mugesram/LoraAgriNode/results/powertest_lora_2026-10-07.csv

pc_time | node | round | rssi_dbm | snr_db | radio_wake_us | ping_setup_us | ping_air_us | pong_setup_us | pong_wait_us | data_setup_us | data_air_us | ack_setup_us | ack_wait_us
2026-10-07 16:12:08 | 2593 | 0 | -17.0 | 12.8 | 25990 | 460 | 36680 | 370 | 79480 | 540 | 67420 | 370 | 80210
2026-10-07 16:12:10 | 2593 | 1 | -20.0 | 13.0 | 1850 | 460 | 36540 | 370 | 79610 | 540 | 67320 | 370 | 80310
2026-10-07 16:12:12 | 2593 | 2 | -18.0 | 12.5 | 1190 | 450 | 36530 | 370 | 80090 | 530 | 67330 | 370 | 80290
2026-10-07 16:12:14 | 2593 | 3 | -20.0 | 12.2 | 1730 | 460 | 36550 | 360 | 79710 | 540 | 67330 | 370 | 80310
2026-10-07 16:12:16 | 2593 | 4 | -21.0 | 12.2 | 2060 | 460 | 36550 | 370 | 79270 | 530 | 67340 | 370 | 80360
2026-10-07 16:12:18 | 2593 | 5 | -24.0 | 12.2 | 1450 | 450 | 36550 | 360 | 79900 | 530 | 67320 | 370 | 80270
2026-10-07 16:12:20 | 2593 | 6 | -23.0 | 13.2 | 1930 | 450 | 36560 | 370 | 79510 | 540 | 67330 | 370 | 80340
2026-10-07 16:12:22 | 2593 | 7 | -23.0 | 12.5 | 1240 | 460 | 36550 | 370 | 79810 | 530 | 67340 | 360 | 80320
2026-10-07 16:12:24 | 2593 | 8 | -23.0 | 12.8 | 1960 | 460 | 36560 | 370 | 79980 | 530 | 67340 | 370 | 80320
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
