mugesram/LoraAgriNode/results/scope_cycle_2026-10-07/full_reduced.csv

time_ms | volts | amps | amps_zero_removed
0.000 | 0.025497 | 0.127487 | 0.000204
0.100 | 0.025510 | 0.127550 | 0.000267
0.200 | 0.025517 | 0.127583 | 0.000300
0.300 | 0.025505 | 0.127525 | 0.000242
0.400 | 0.025507 | 0.127533 | 0.000250
0.500 | 0.025502 | 0.127508 | 0.000225
0.600 | 0.025498 | 0.127492 | 0.000208
0.700 | 0.025503 | 0.127517 | 0.000233
0.800 | 0.025494 | 0.127471 | 0.000188
0.900 | 0.025492 | 0.127462 | 0.000179
1.000 | 0.025497 | 0.127487 | 0.000204
1.100 | 0.025494 | 0.127471 | 0.000188
1.200 | 0.025500 | 0.127500 | 0.000217
1.300 | 0.025510 | 0.127550 | 0.000267
1.400 | 0.025503 | 0.127517 | 0.000233
1.500 | 0.025502 | 0.127508 | 0.000225
1.600 | 0.025506 | 0.127529 | 0.000246
1.700 | 0.025509 | 0.127546 | 0.000263
1.800 | 0.025498 | 0.127492 | 0.000208
1.900 | 0.025487 | 0.127437 | 0.000154
2.000 | 0.025480 | 0.127400 | 0.000117
2.100 | 0.025473 | 0.127367 | 0.000083
2.200 | 0.025485 | 0.127425 | 0.000142
2.300 | 0.025495 | 0.127475 | 0.000192
2.400 | 0.025496 | 0.127479 | 0.000196
2.500 | 0.025497 | 0.127487 | 0.000204
2.600 | 0.025488 | 0.127442 | 0.000158
2.700 | 0.025503 | 0.127517 | 0.000233
2.800 | 0.025523 | 0.127617 | 0.000333
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
