mugesram/LoraAgriNode/results/scope_lora_2026-10-07/C1_2_reduced.csv

time_ms | volts | amps
0.000 | 0.000667 | 0.000133
0.100 | 0.000667 | 0.000133
0.200 | 0.000658 | 0.000132
0.300 | 0.000667 | 0.000133
0.400 | 0.000667 | 0.000133
0.500 | 0.000665 | 0.000133
0.600 | 0.000660 | 0.000132
0.700 | 0.000658 | 0.000132
0.800 | 0.000668 | 0.000134
0.900 | 0.000670 | 0.000134
1.000 | 0.000665 | 0.000133
1.100 | 0.000668 | 0.000134
1.200 | 0.000667 | 0.000133
1.300 | 0.000667 | 0.000133
1.400 | 0.000670 | 0.000134
1.500 | 0.000660 | 0.000132
1.600 | 0.000643 | 0.000129
1.700 | 0.000657 | 0.000131
1.800 | 0.000663 | 0.000133
1.900 | 0.000668 | 0.000134
2.000 | 0.000685 | 0.000137
2.100 | 0.000688 | 0.000138
2.200 | 0.000673 | 0.000135
2.300 | 0.000695 | 0.000139
2.400 | 0.000683 | 0.000137
2.500 | 0.000677 | 0.000135
2.600 | 0.000683 | 0.000137
2.700 | 0.000682 | 0.000136
2.800 | 0.000667 | 0.000133
2.900 | 0.000667 | 0.000133
3.000 | 0.000657 | 0.000131
3.100 | 0.000668 | 0.000134
3.200 | 0.000655 | 0.000131
3.300 | 0.000662 | 0.000132
3.400 | 0.000673 | 0.000135
3.500 | 0.000690 | 0.000138
3.600 | 0.000712 | 0.000142
3.700 | 0.000733 | 0.000147
3.800 | 0.000717 | 0.000143
3.900 | 0.000670 | 0.000134
4.000 | 0.000668 | 0.000134
4.100 | 0.000667 | 0.000133
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
