mugesram/LoraAgriNode/results/scope_lora_2026-10-07/C1_3_reduced.csv

time_ms | volts | amps
0.000 | 0.025498 | 0.127492
0.100 | 0.025493 | 0.127467
0.200 | 0.025498 | 0.127492
0.300 | 0.025500 | 0.127500
0.400 | 0.025502 | 0.127508
0.500 | 0.025495 | 0.127475
0.600 | 0.025483 | 0.127417
0.700 | 0.025492 | 0.127458
0.800 | 0.025475 | 0.127375
0.900 | 0.025478 | 0.127392
1.000 | 0.025477 | 0.127383
1.100 | 0.025492 | 0.127458
1.200 | 0.025490 | 0.127450
1.300 | 0.025482 | 0.127408
1.400 | 0.025462 | 0.127308
1.500 | 0.025420 | 0.127100
1.600 | 0.025415 | 0.127075
1.700 | 0.025428 | 0.127142
1.800 | 0.025432 | 0.127158
1.900 | 0.025373 | 0.126867
2.000 | 0.025377 | 0.126883
2.100 | 0.025403 | 0.127017
2.200 | 0.025418 | 0.127092
2.300 | 0.025410 | 0.127050
2.400 | 0.025415 | 0.127075
2.500 | 0.025395 | 0.126975
2.600 | 0.025377 | 0.126883
2.700 | 0.025403 | 0.127017
2.800 | 0.025432 | 0.127158
2.900 | 0.025455 | 0.127275
3.000 | 0.025448 | 0.127242
3.100 | 0.025445 | 0.127225
3.200 | 0.025438 | 0.127192
3.300 | 0.025425 | 0.127125
3.400 | 0.025460 | 0.127300
3.500 | 0.025418 | 0.127092
3.600 | 0.025472 | 0.127358
3.700 | 0.025490 | 0.127450
3.800 | 0.025495 | 0.127475
3.900 | 0.025463 | 0.127317
4.000 | 0.025442 | 0.127208
4.100 | 0.025438 | 0.127192
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
