mugesram/LoraAgriNode/results/scope_lora_2026-10-07/lora_reduced.csv

time_ms | volts | amps | amps_zero_removed
0.000 | 0.025897 | 0.129483 | 0.000883
0.100 | 0.025890 | 0.129450 | 0.000850
0.200 | 0.025890 | 0.129450 | 0.000850
0.300 | 0.025840 | 0.129200 | 0.000600
0.400 | 0.025770 | 0.128850 | 0.000250
0.500 | 0.025707 | 0.128533 | -0.000067
0.600 | 0.025743 | 0.128717 | 0.000117
0.700 | 0.025797 | 0.128983 | 0.000383
0.800 | 0.025750 | 0.128750 | 0.000150
0.900 | 0.025813 | 0.129067 | 0.000467
1.000 | 0.025713 | 0.128567 | -0.000033
1.100 | 0.025607 | 0.128033 | -0.000567
1.200 | 0.025540 | 0.127700 | -0.000900
1.300 | 0.025633 | 0.128167 | -0.000433
1.400 | 0.025690 | 0.128450 | -0.000150
1.500 | 0.025737 | 0.128683 | 0.000083
1.600 | 0.025720 | 0.128600 | 0.000000
1.700 | 0.025617 | 0.128083 | -0.000517
1.800 | 0.025570 | 0.127850 | -0.000750
1.900 | 0.025623 | 0.128117 | -0.000483
2.000 | 0.025710 | 0.128550 | -0.000050
2.100 | 0.025770 | 0.128850 | 0.000250
2.200 | 0.025787 | 0.128933 | 0.000333
2.300 | 0.025723 | 0.128617 | 0.000017
2.400 | 0.025663 | 0.128317 | -0.000283
2.500 | 0.025603 | 0.128017 | -0.000583
2.600 | 0.025583 | 0.127917 | -0.000683
2.700 | 0.025643 | 0.128217 | -0.000383
2.800 | 0.025713 | 0.128567 | -0.000033
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
