mugesram/LoraAgriNode/results/scope_cycle_2026-10-07/full.png

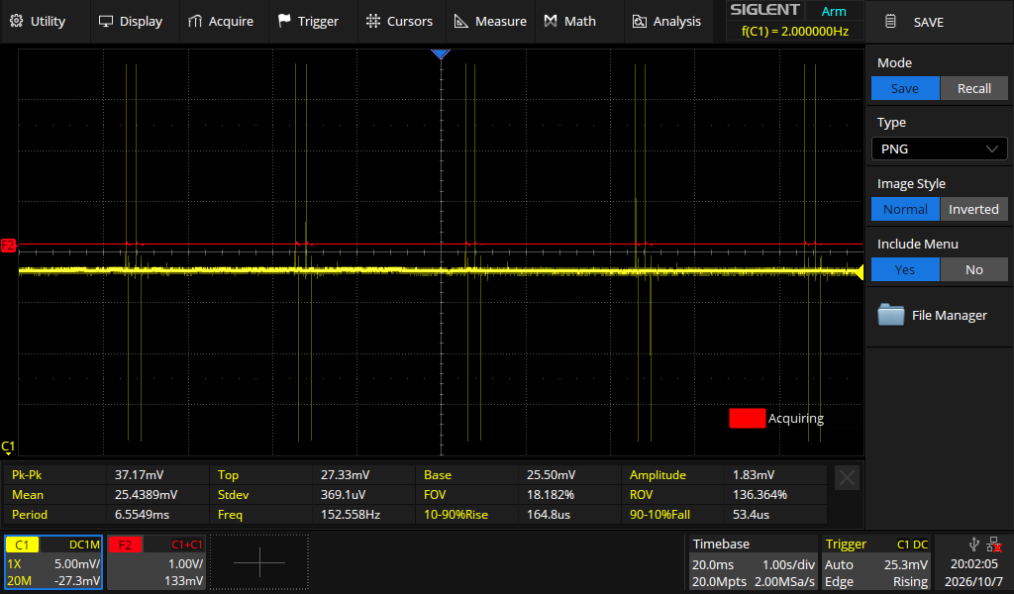
results/scope_cycle_2026-10-07/full.png
