mugesram/LoraAgriNode/results/scope_lora_2026-10-07/lora.png

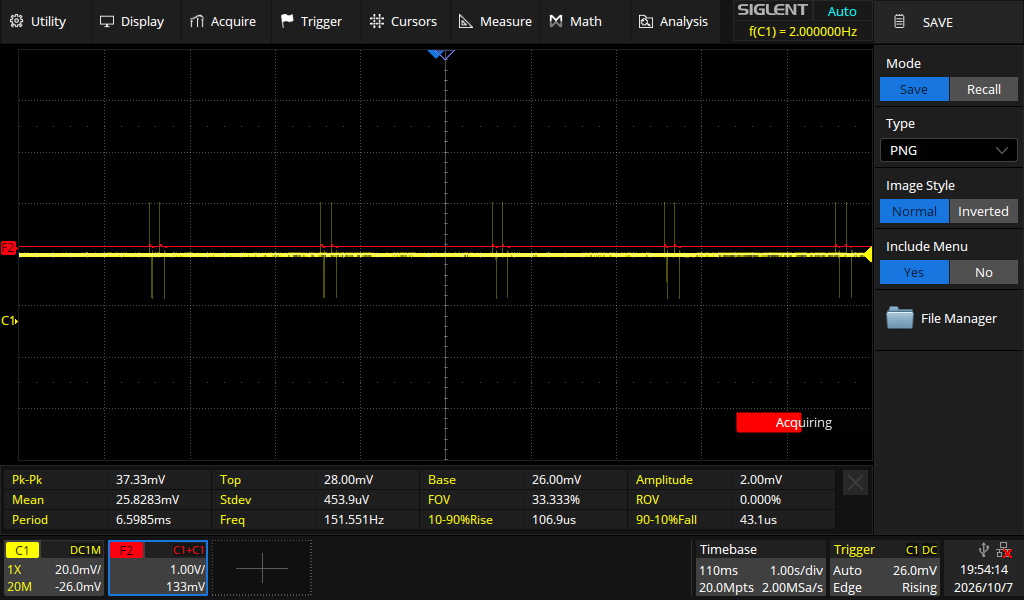
results/scope_lora_2026-10-07/lora.png
