mugesram/LoraAgriNode/results/scope_lora_2026-10-07/scope_1.png

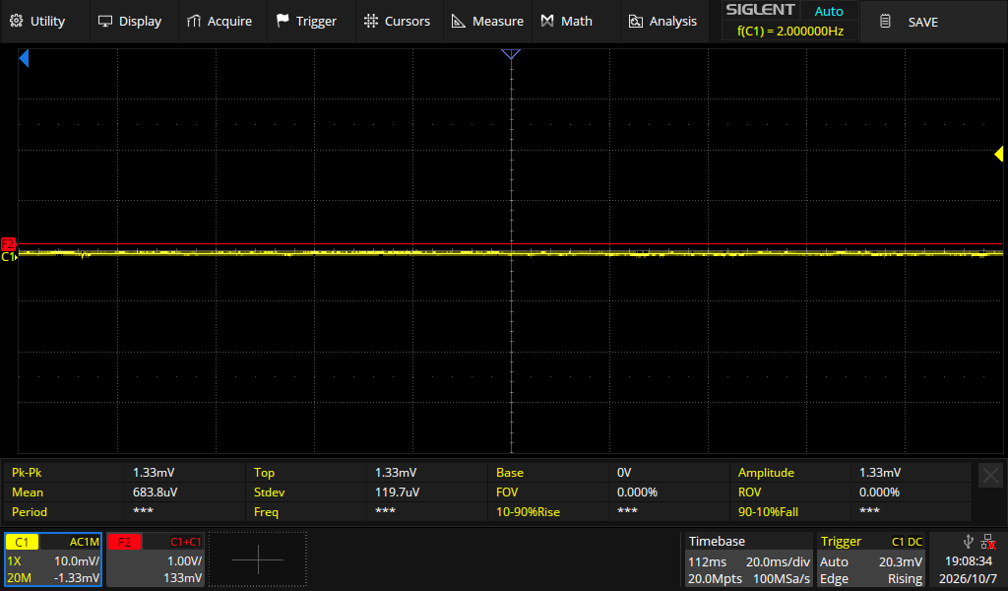
results/scope_lora_2026-10-07/scope_1.png
