mugesram/LoraAgriNode/results/scope_lora_2026-10-07/scope_2.png

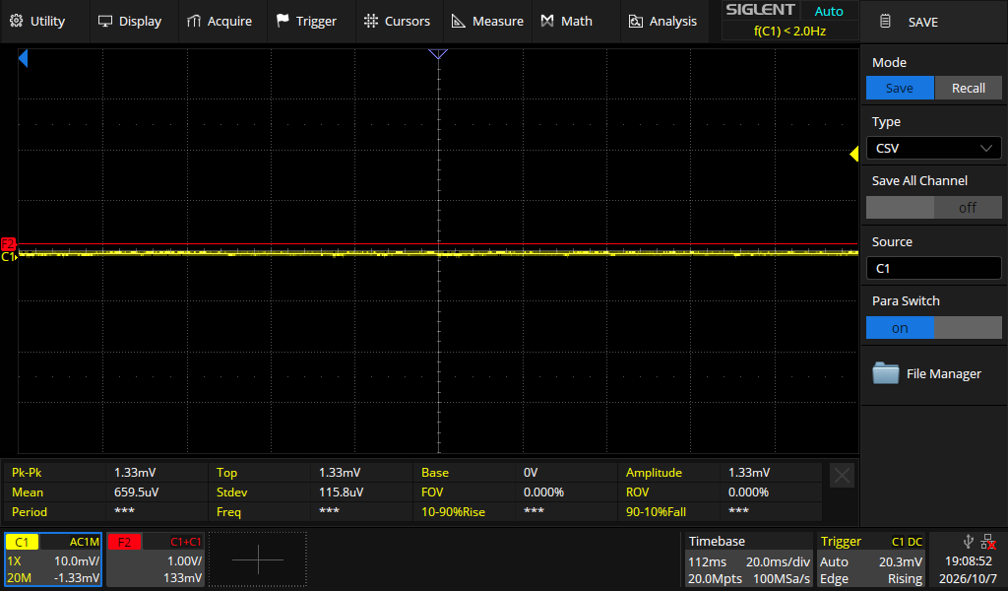
results/scope_lora_2026-10-07/scope_2.png
