mugesram/LoraAgriNode/results/scope_shunt_1R1_2026-10-07/fullres.png

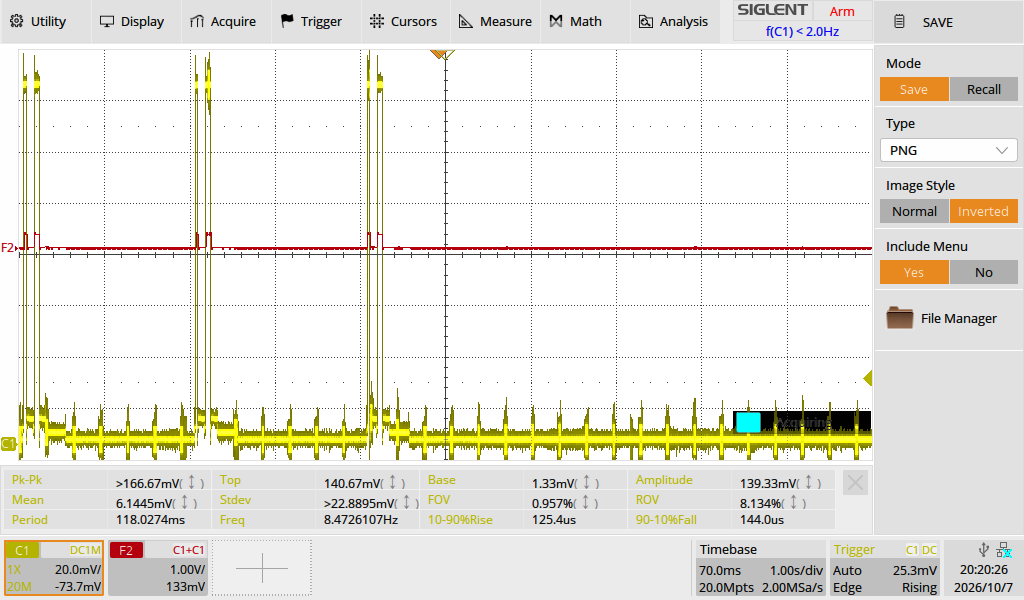
results/scope_shunt_1R1_2026-10-07/fullres.png
