mugesram/LoraAgriNode/hardware/entc-sensornode-1_schematic.pdf

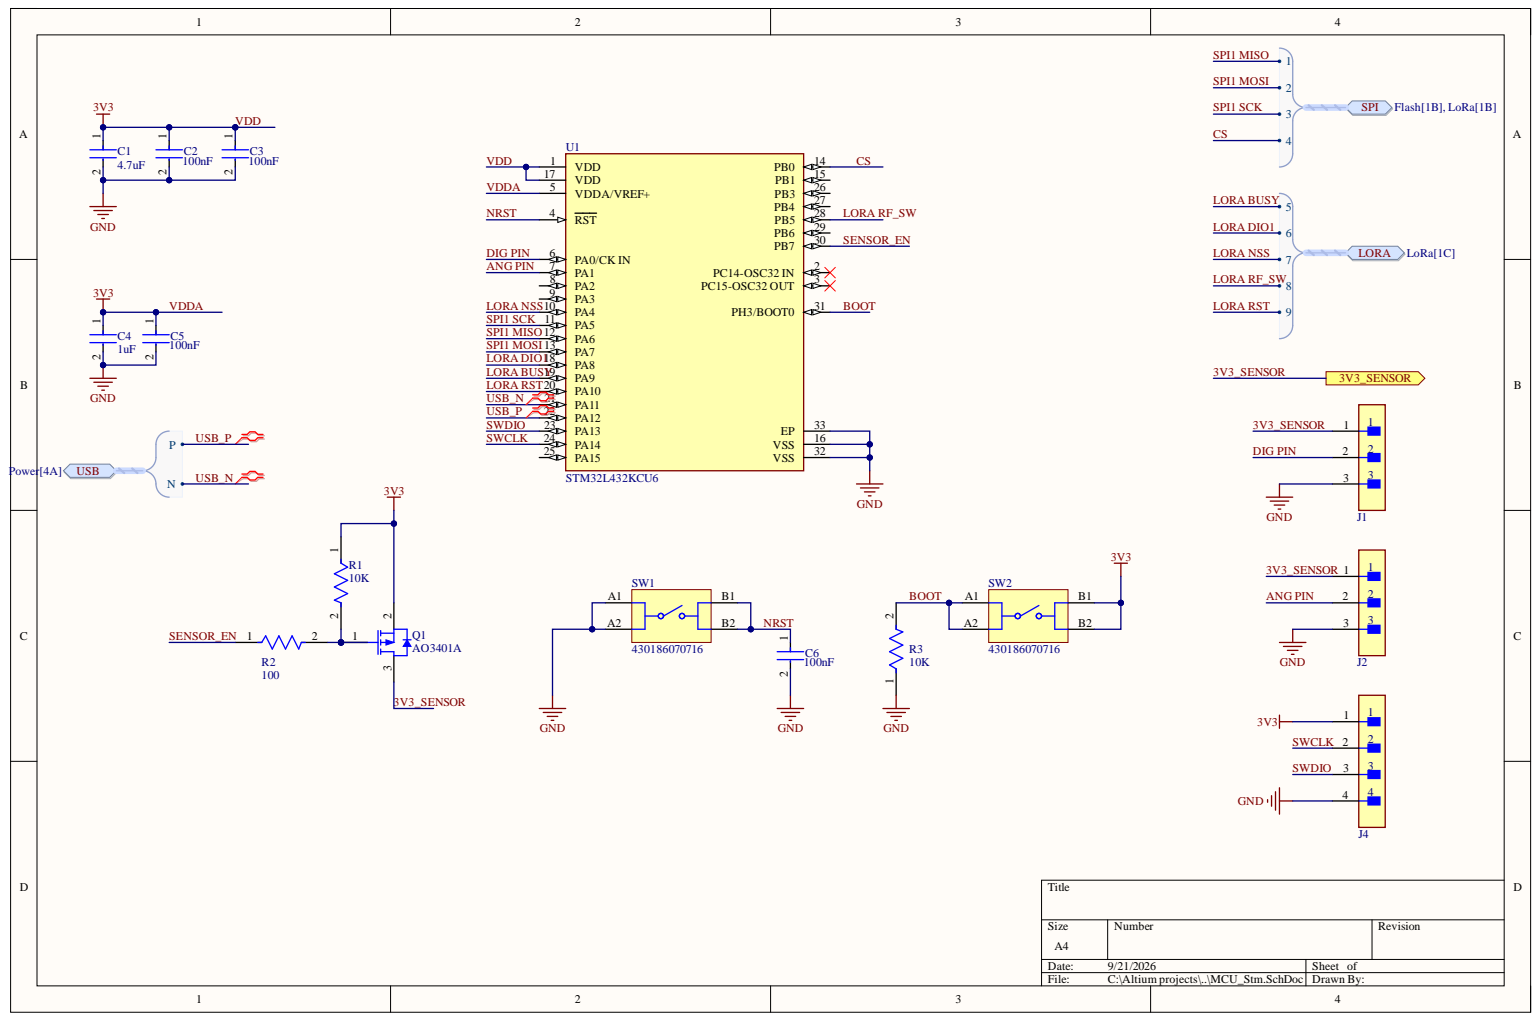
[picture p10: page 1]

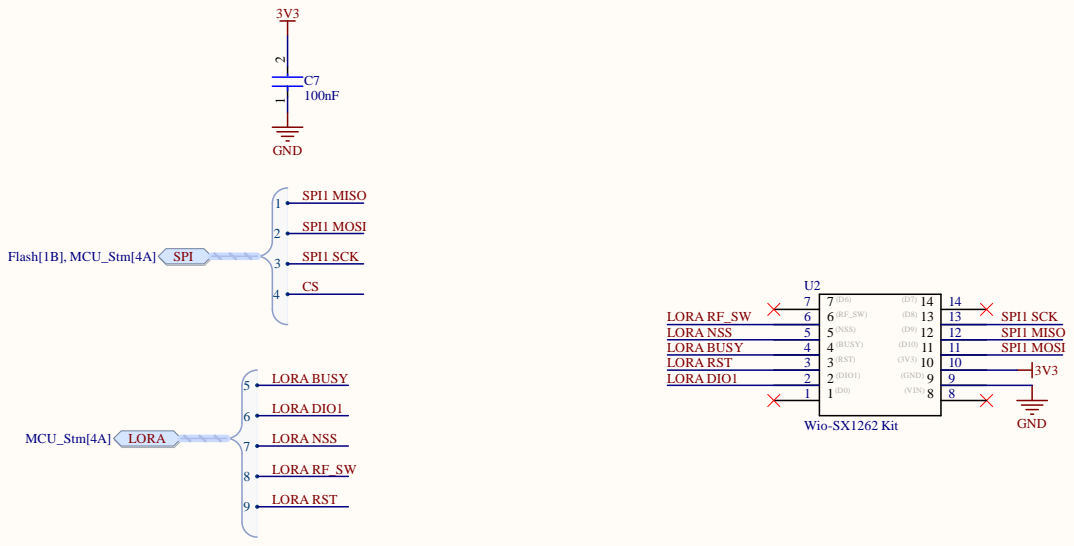
[picture p11: page 2]
Title; Size; Number; Revision; Date:; Sheet of; File:; C:\Altium projects\..\LoRa.SchDoc; Drawn By:; SPI1 MISO; SPI1 SCK; LORA RST; LORA NSS; LORA BUSY; SPI1 MOSI; LORA DIO1; LORA RF_SW; 5 ⁽NSS); 4 ⁽BUSY); 3 ⁽RST); 2 ⁽DIO1); 9 ⁽GND); 8 ⁽VIN); Wio-SX1262 Kit; GND; MCU_Stm[4A]; LORA; Flash[1B], MCU_Stm[4A]; SPI

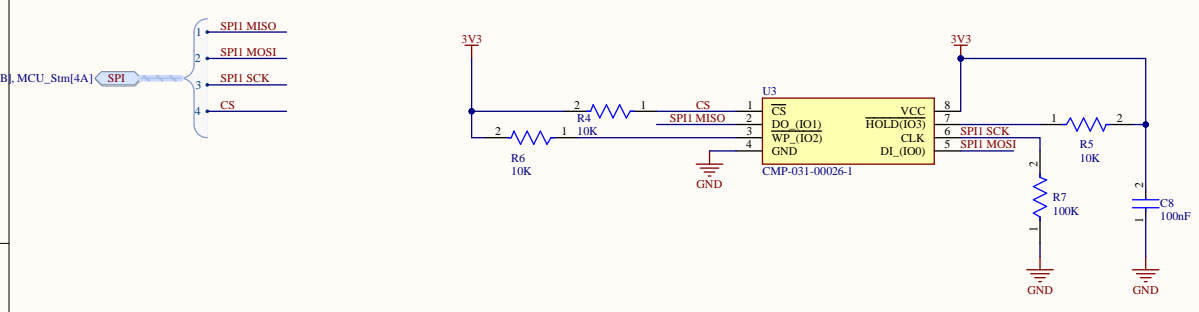
[picture p12: page 3]
Size; umb; Rev; Dat; Sheet; project; \..\Flas; Draw; VCC; CMP-0; SPI1 SCK SPI1 MOSI; CS SPI1 MISO; SPI1 MISO; SPI1 MOSI; SPI1 SCK; oRa[1B], MCU; _Stm[4; SPI

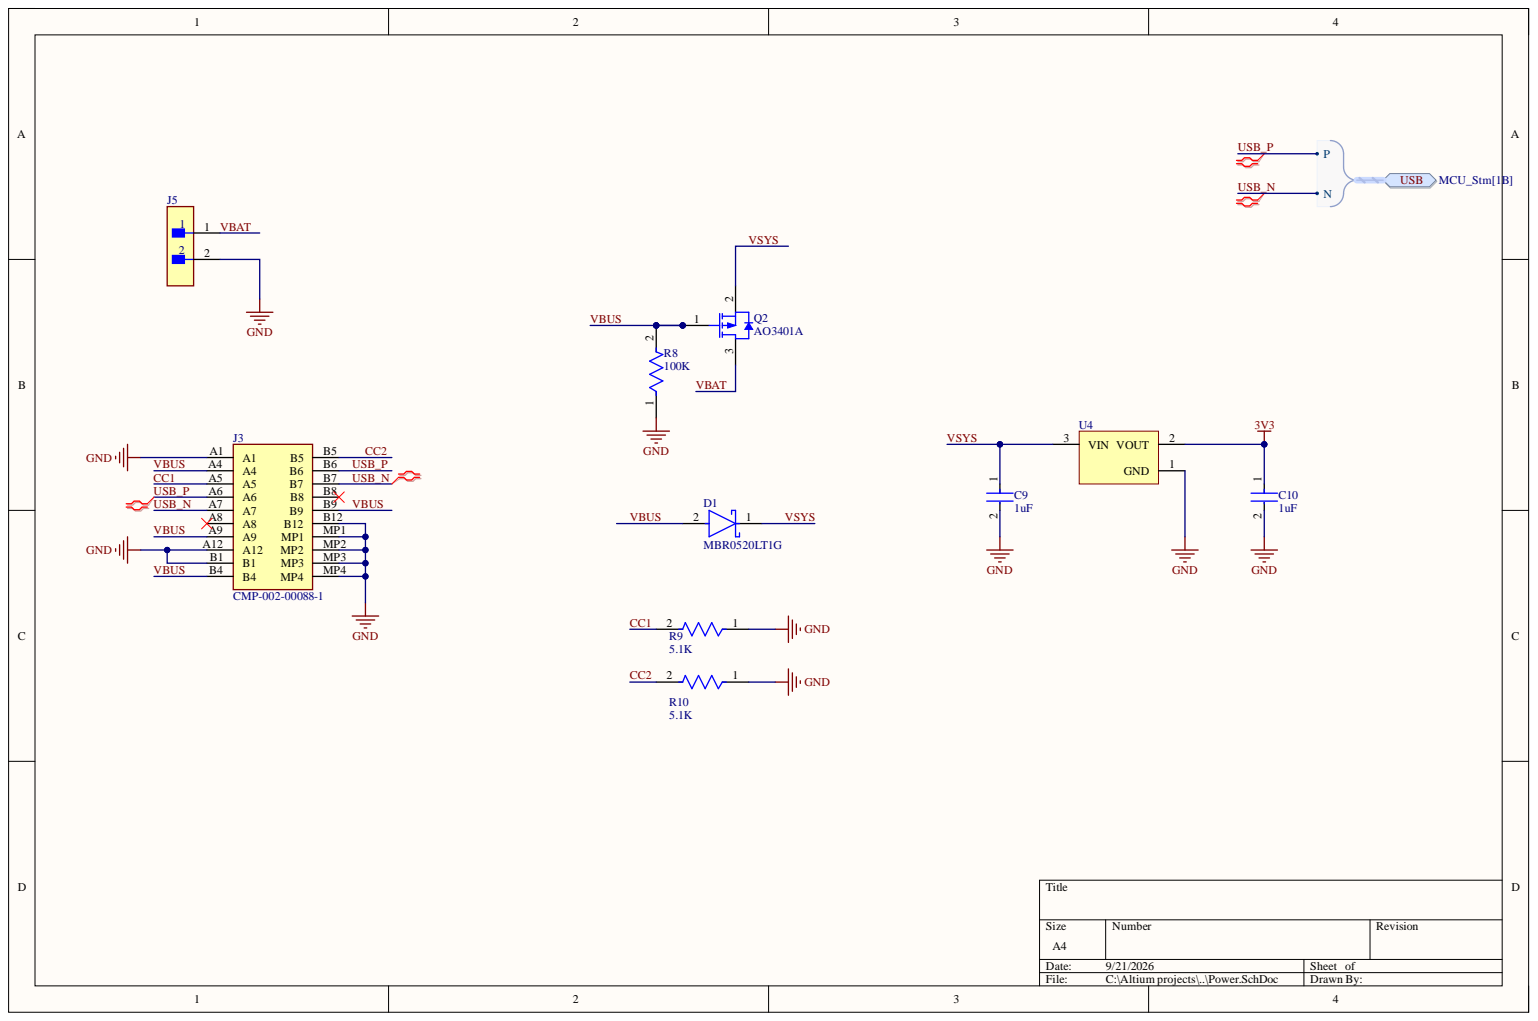
[picture p13: page 4]
Size; umb; Rev; Dat; Sheet; project; wer.Sc; Draw; VBAT; VSY; CMP-0; USB_; MBR0; VBU; USB; MCU; _Stm[1

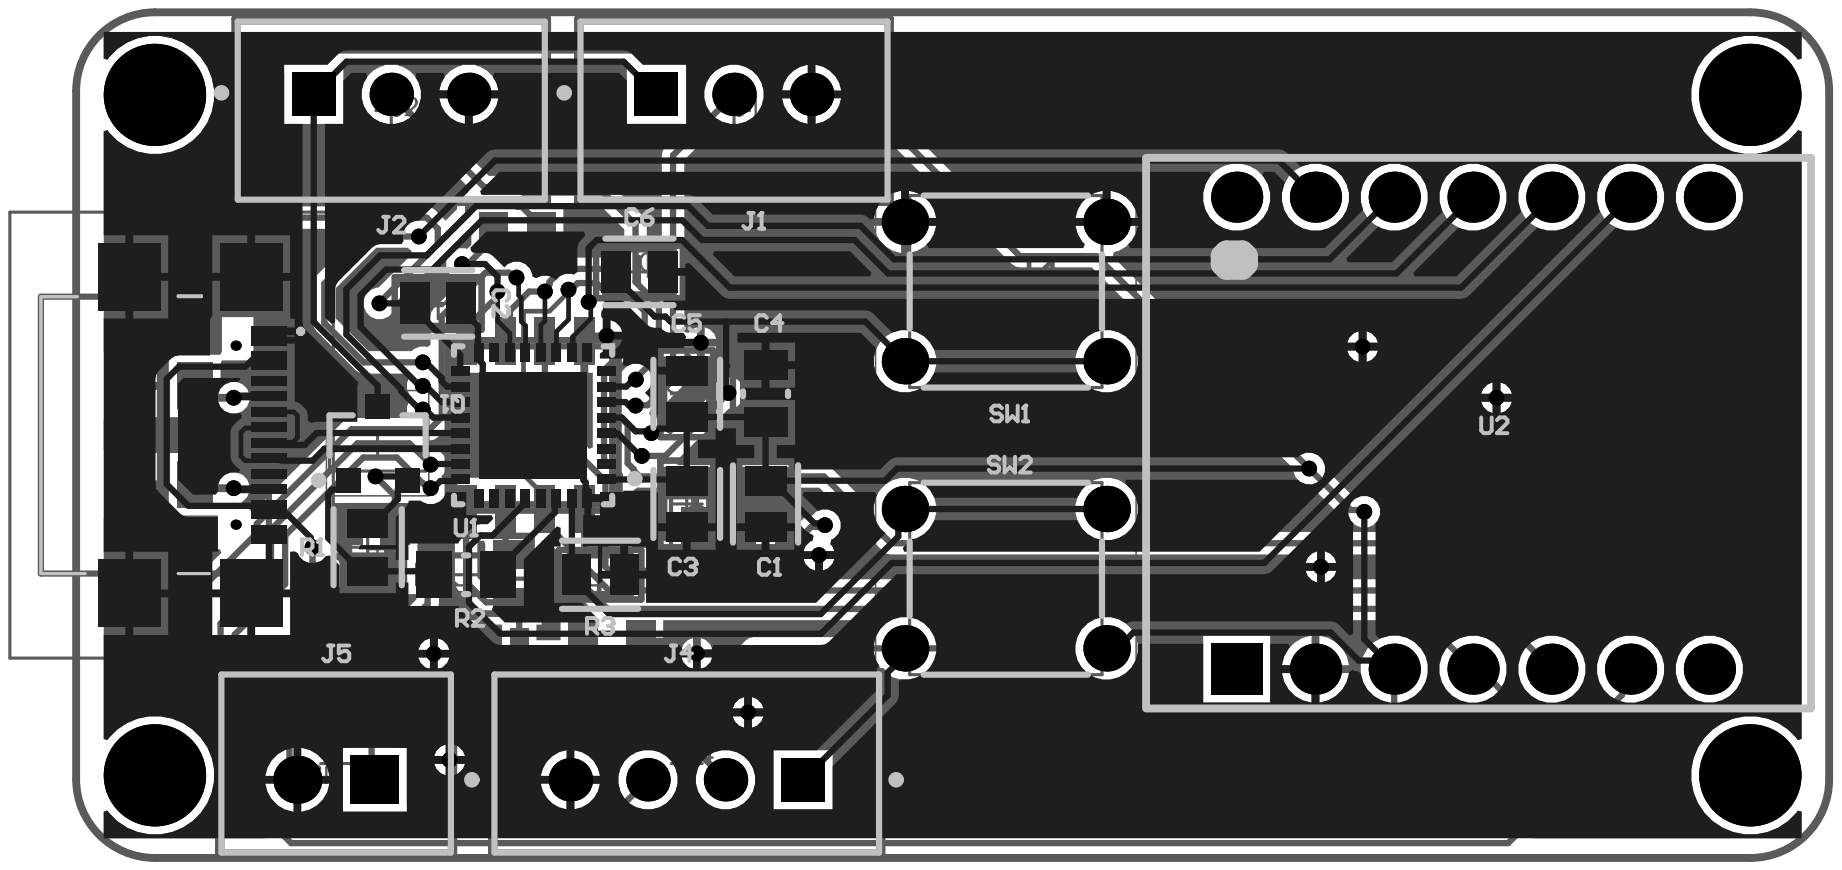
[picture p14: page 5]
