mugesram/LoraAgriNode/(commit log)

2026-10-07 Add node firmware, gateway, server, measurements and cycle diagrams
    Node firmware for the entc-sensornode-1 board (STM32L432 + SX1262),
    gateway firmware for the XIAO ESP32S3, the laptop server and web page,
    power and timing measurements, and flowcharts of one battery-mode cycle.
2026-10-13 Add board schematic, PCB render and photo; show them in README
